thaninahamidouche/Projet-Robotique-GRP4/Lanceur VFinal.jpeg

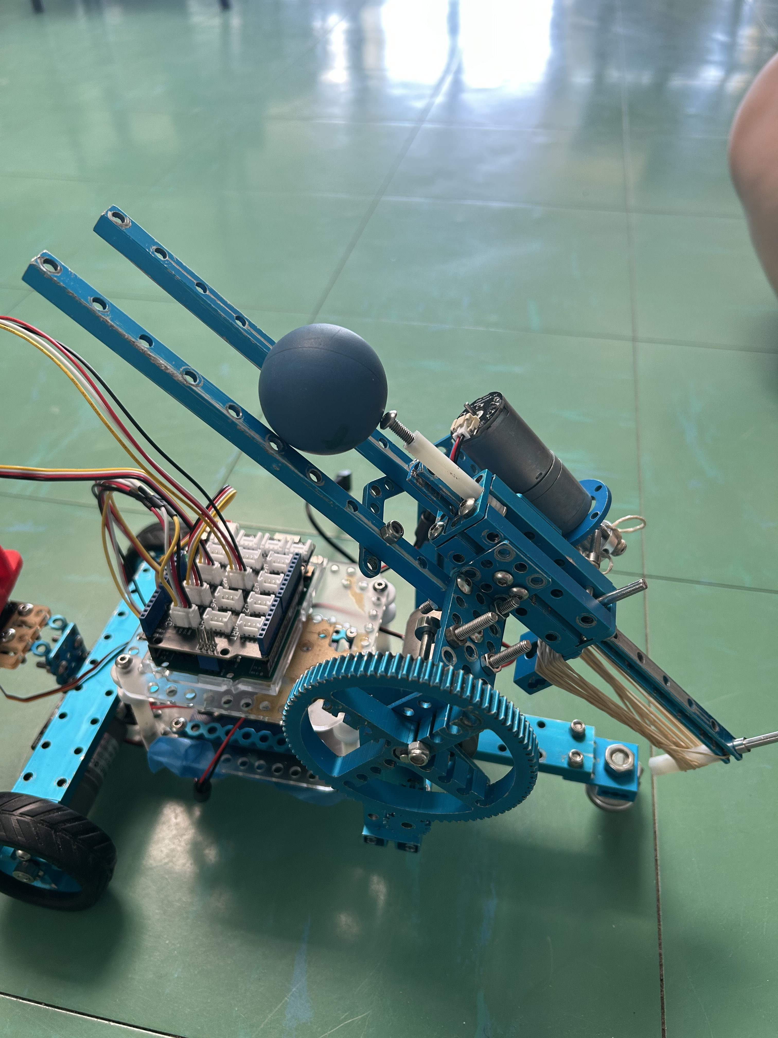
Lanceur VFinal.jpeg
