thaninahamidouche/Projet-Robotique-GRP4/Chronometrage/README.md

# Circuit de Chronométrage

## Présentation

Dans le cadre du projet robotique, j'ai conçu et réalisé un circuit de chronométrage permettant de mesurer automatiquement le temps de passage du robot entre deux barrières de détection.

Le circuit est basé sur des composants logiques et permet d'afficher le temps mesuré sur deux afficheurs 7 segments.

## Objectif

L'objectif du projet est de :

- Déclencher automatiquement le chronomètre lors du passage du robot devant la première barrière.
- Arrêter automatiquement le comptage à la seconde barrière.
- Afficher le temps mesuré sur deux afficheurs 7 segments.
- Concevoir une carte électronique fonctionnelle sous KiCad.

## Travail réalisé

J'ai réalisé l'ensemble de la partie chronométrage du projet :

- Étude du cahier des charges.
- Conception du schéma électronique.
- Choix des composants et des footprints.
- Conception et routage du PCB sous KiCad.
- Analyse et correction des erreurs du circuit.
- Préparation de la documentation technique.

## Composants utilisés

- NE555 : génération de l'horloge.
- CD4013 : gestion du démarrage et de l'arrêt du comptage.
- CD4518 : compteur BCD.
- CD4511 : décodeur pour afficheurs 7 segments.
- Afficheurs 7 segments.
- Connecteur DB25.

## Difficultés rencontrées

Le développement du circuit a nécessité plusieurs phases de correction et d'adaptation :

- Reprise du typon à plusieurs reprises.
- Correction du routage après analyse du circuit.
- Contraintes liées à la fabrication et aux tests.
- Adaptation du circuit suite aux modifications demandées durant le projet.

Malgré ces contraintes, le circuit a été entièrement analysé, corrigé et finalisé (par moi).

## Compétences développées

- Électronique numérique
- Conception de schémas électroniques
- Routage PCB sous KiCad
- Analyse et correction de circuits
- Gestion de versions avec GitHub
- Résolution de problèmes techniques
- Perçage, soudage et implantation de composants en même pas 2h.

## Auteur

Sarah Rabia

Projet Robotique – Circuit de Chronométrage

Année universitaire 2025-2026
