thaninahamidouche/Projet-Robotique-GRP4/20260519_163420.jpg

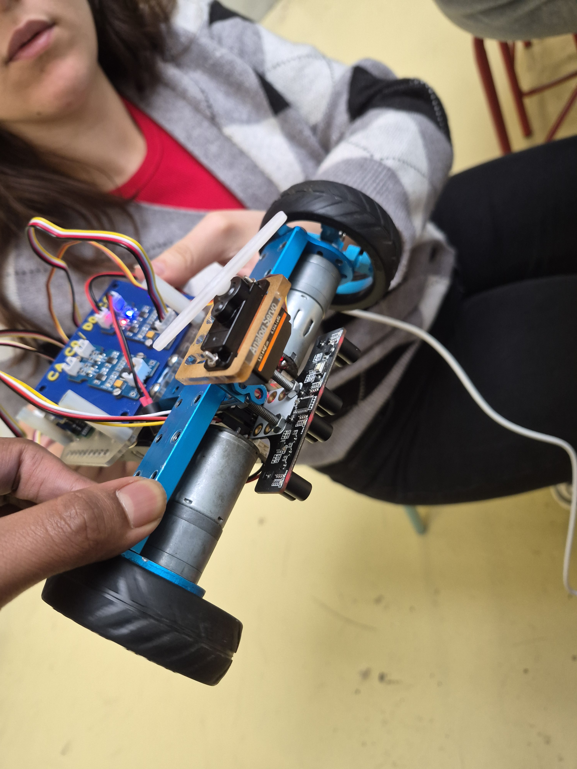
20260519_163420.jpg
