thaninahamidouche/Projet-Robotique-GRP4/20260521_100904.jpg

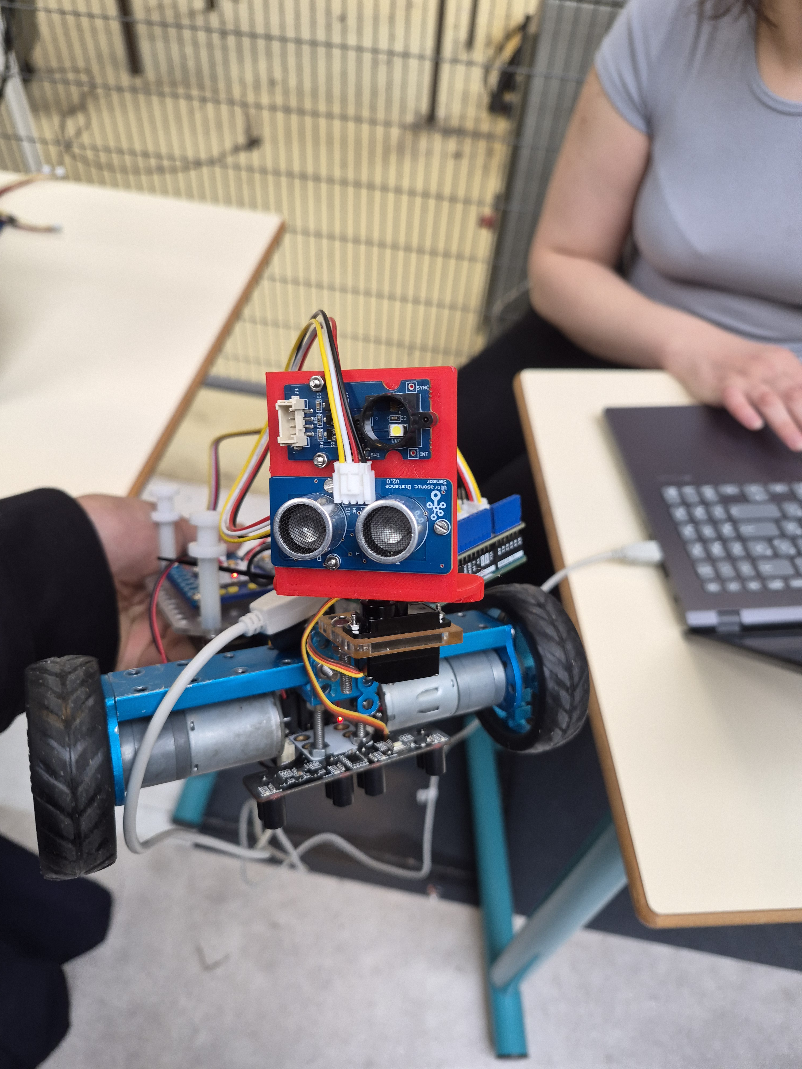
20260521_100904.jpg
