thaninahamidouche/Projet-Robotique-GRP4/20260522_160010.jpg

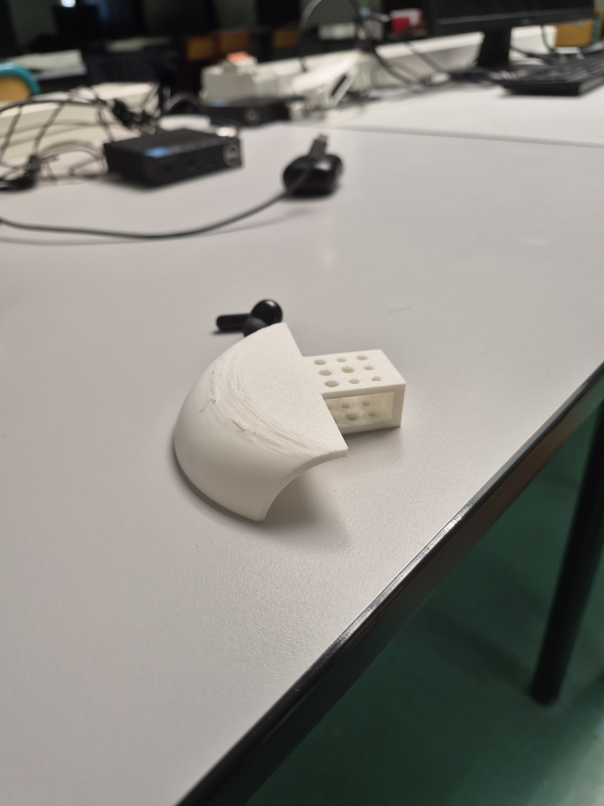
20260522_160010.jpg
