thaninahamidouche/Projet-Robotique-GRP4/Capture d’écran 2026-05-24 160932.png

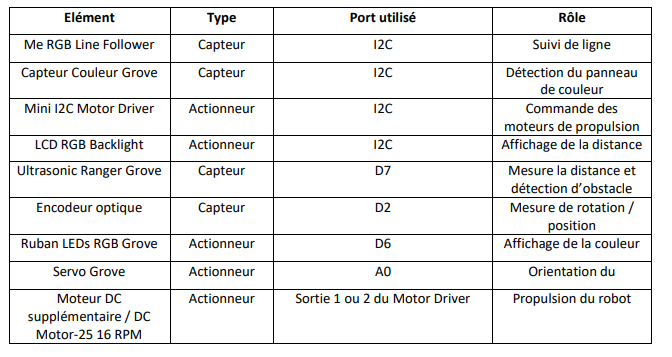
Capture d’écran 2026-05-24 160932.png
