thaninahamidouche/Projet-Robotique-GRP4/Chronometrage/Circuit_Final.jpeg

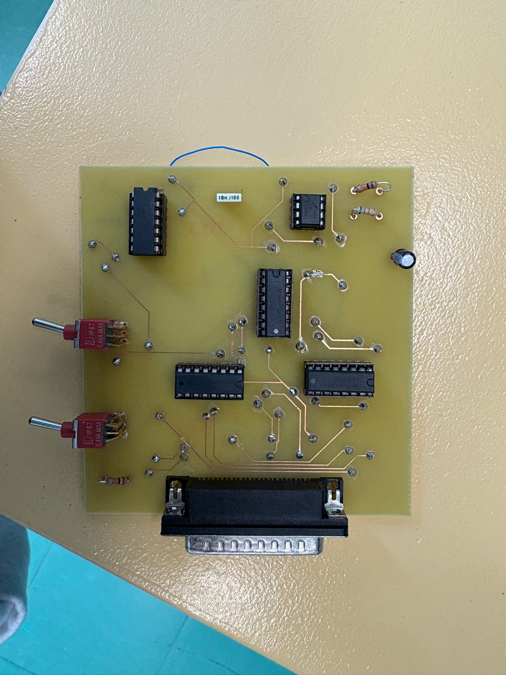
Chronometrage/Circuit_Final.jpeg
