thaninahamidouche/Projet-Robotique-GRP4/Chronometrage/Circuit_Finale_B.jpeg

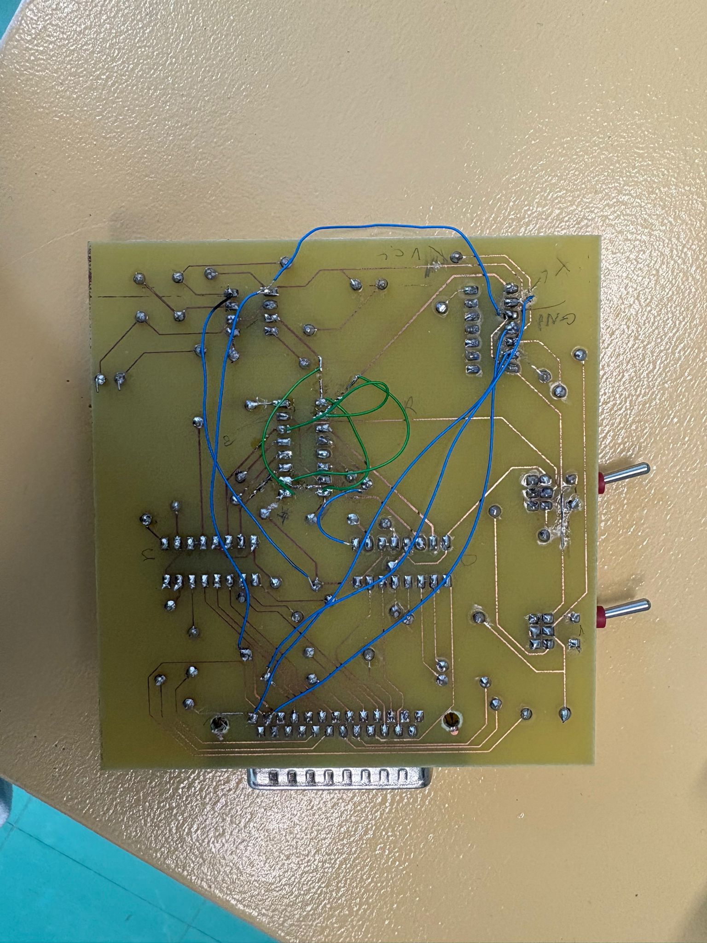
Chronometrage/Circuit_Finale_B.jpeg
