thaninahamidouche/Projet-Robotique-GRP4/Chronometrage/PCB_Chrono.png

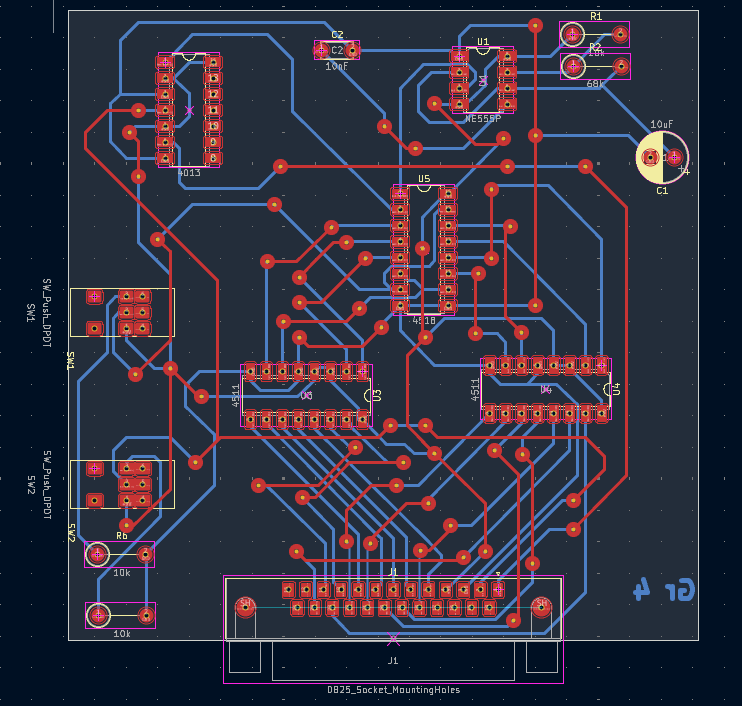
Chronometrage/PCB_Chrono.png
