thaninahamidouche/Projet-Robotique-GRP4/Chronometrage/Schematic_Chrono.png

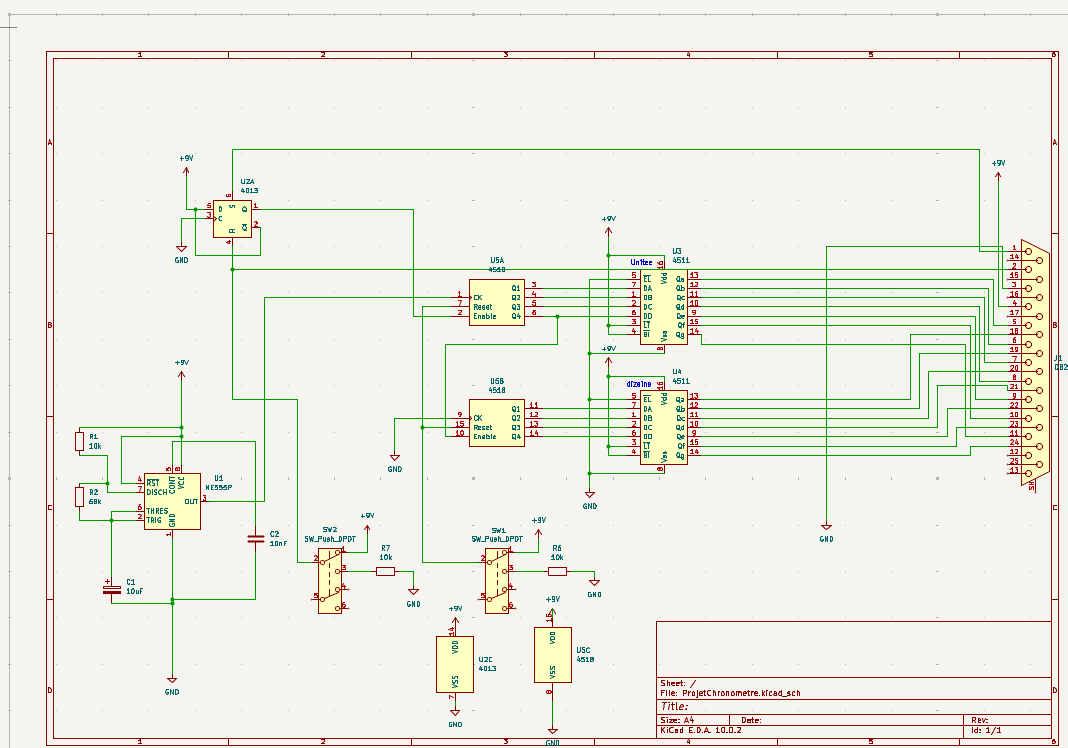
Chronometrage/Schematic_Chrono.png
