thaninahamidouche/Projet-Robotique-GRP4/Chronometrage/Shematic_Chrono_Apres_modif.png

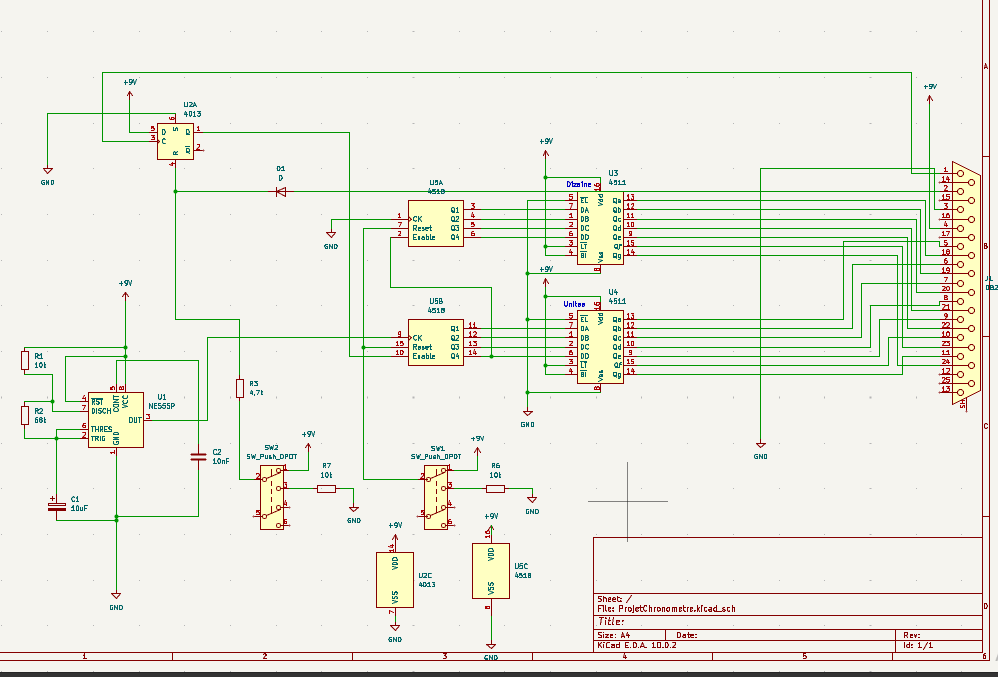
Chronometrage/Shematic_Chrono_Apres_modif.png
