thaninahamidouche/Projet-Robotique-GRP4/Chronometrage/Simulation_Chrono.png

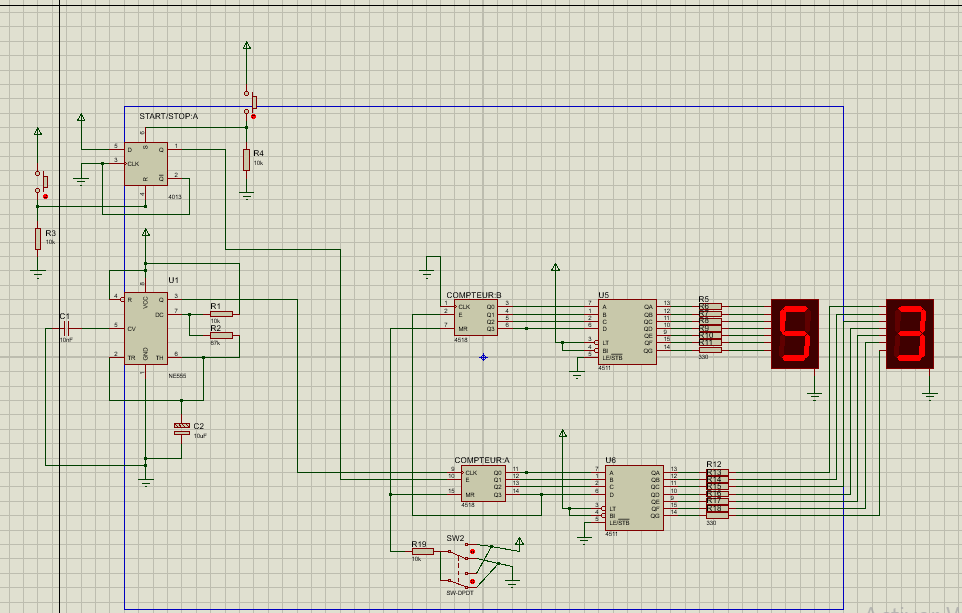
Chronometrage/Simulation_Chrono.png
