thaninahamidouche/Projet-Robotique-GRP4/Chronometrage/Simulation_reel.jpeg

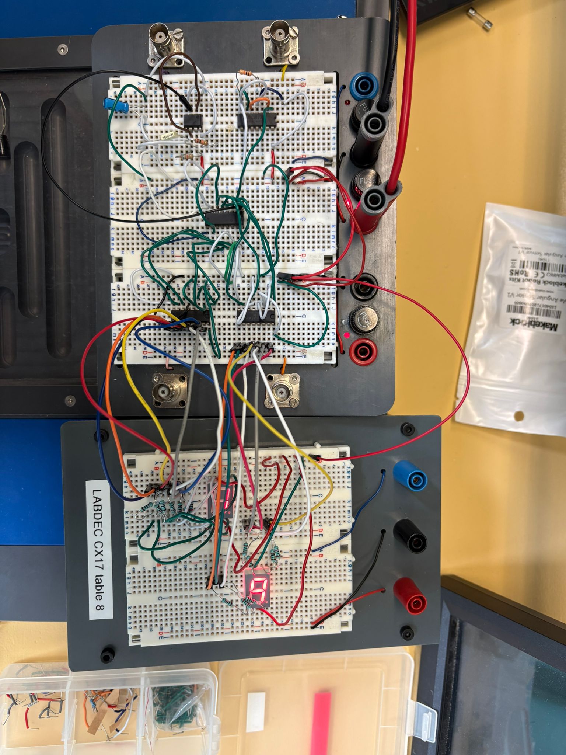
Chronometrage/Simulation_reel.jpeg
