thaninahamidouche/Projet-Robotique-GRP4/Chronometrage/Vu3D.png

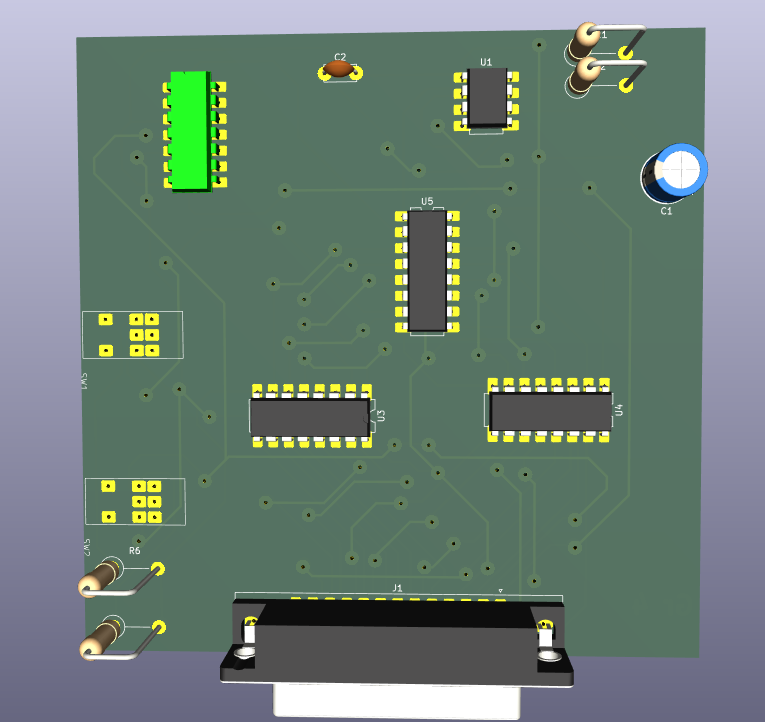
Chronometrage/Vu3D.png
