thaninahamidouche/Projet-Robotique-GRP4/Lanceur Final.jpeg

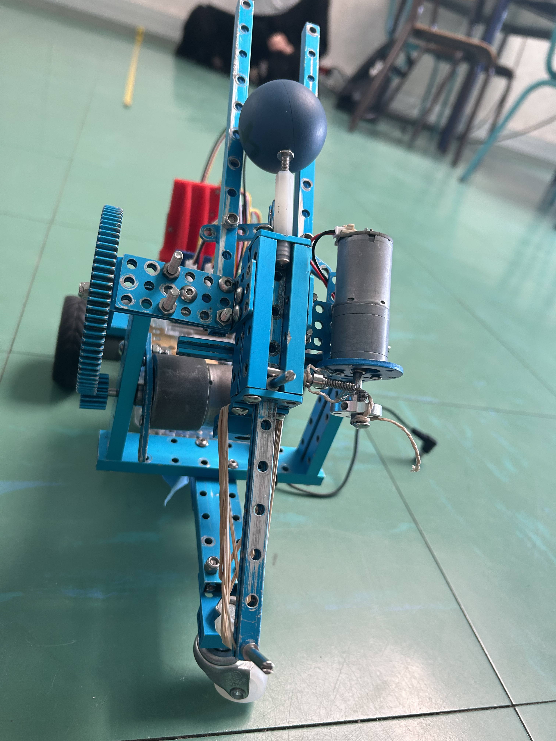
Lanceur Final.jpeg
