thaninahamidouche/Projet-Robotique-GRP4/Lanceur V1.jpeg

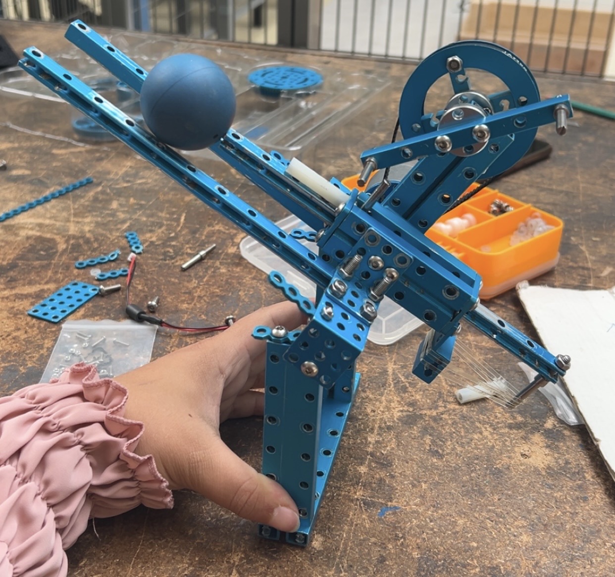
Lanceur V1.jpeg
