thaninahamidouche/Projet-Robotique-GRP4/02.Programmes Sections/afficahgerampe.V3/afficahgerampe.V3.ino

#include <Arduino.h>
#include <Wire.h>
#include <MeOrion.h>
#include <Adafruit_NeoPixel.h>

// ==================================================
// BRANCHEMENTS
// Ruban LED        -> D6
// Ultrason         -> D7
// Capteur couleur  -> I2C
// ==================================================

const int sigPin = 7;

// ==================================================
// RUBAN LED
// ==================================================

#define LED_PIN 6
#define NB_LEDS 30

Adafruit_NeoPixel strip(NB_LEDS, LED_PIN, NEO_GRB + NEO_KHZ800);

// ==================================================
// MOTEURS
// ==================================================

#define MOTEUR_A 0x66
#define MOTEUR_B 0x68

#define ARRET   0x00
#define AVANT   0x01
#define ARRIERE 0x02

const byte VITESSE = 30;

// Distance arrêt
const float DIST_STOP = 2.0;

// ==================================================
// CAPTEUR COULEUR I2C
// ==================================================

#define COLOR_ADDR 0x29

// ==================================================
// SETUP
// ==================================================

void setup() {

  Serial.begin(9600);
  Wire.begin();

  // Ruban LED
  strip.begin();
  strip.clear();
  strip.show();

  // Capteur couleur
  initColorSensor();

  arreter();

  Serial.println("Robot pret");
}

// ==================================================
// LOOP
// ==================================================

void loop() {

  float distance = mesurerDistance();

  Serial.print("Distance : ");
  Serial.print(distance);
  Serial.println(" cm");

  // STOP à 2 cm
  if(distance <= DIST_STOP && distance > 0) {

    arreter();
    delay(50);

    arreter();

    Serial.println("STOP - obstacle detecte");

    delay(500);

    afficherCouleur();

    while(true) {
      arreter();
    }
  }

  avancer();

  delay(20);
}

// ==================================================
// ULTRASON D7
// ==================================================

float mesurerDistance() {

  pinMode(sigPin, OUTPUT);

  digitalWrite(sigPin, LOW);
  delayMicroseconds(2);

  digitalWrite(sigPin, HIGH);
  delayMicroseconds(10);

  digitalWrite(sigPin, LOW);

  pinMode(sigPin, INPUT);

  long duree = pulseIn(sigPin, HIGH, 30000);

  if(duree == 0) {
    return 400;
  }

  float distance = duree * 0.034 / 2.0;

  return distance;
}

// ==================================================
// MOTEURS
// ==================================================

void piloterMoteur(byte adresse, byte direction, byte vitesse) {

  if(vitesse > 63) {
    vitesse = 63;
  }

  byte commande = (vitesse << 2) | direction;

  Wire.beginTransmission(adresse);
  Wire.write(0x00);
  Wire.write(commande);
  Wire.endTransmission();
}

void avancer() {

  piloterMoteur(MOTEUR_A, AVANT, VITESSE);
  piloterMoteur(MOTEUR_B, ARRIERE, VITESSE);
}

void arreter() {

  piloterMoteur(MOTEUR_A, ARRET, 0);
  piloterMoteur(MOTEUR_B, ARRET, 0);

  delay(20);

  // sécurité
  piloterMoteur(MOTEUR_A, ARRET, 0);
  piloterMoteur(MOTEUR_B, ARRET, 0);
}

// ==================================================
// CAPTEUR COULEUR
// ==================================================

void writeColorRegister(byte reg, byte value) {

  Wire.beginTransmission(COLOR_ADDR);
  Wire.write(0x80 | reg);
  Wire.write(value);
  Wire.endTransmission();
}

uint16_t readColorRegister16(byte reg) {

  Wire.beginTransmission(COLOR_ADDR);
  Wire.write(0x80 | reg);
  Wire.endTransmission();

  Wire.requestFrom(COLOR_ADDR, 2);

  if(Wire.available() < 2) {
    return 0;
  }

  uint16_t low = Wire.read();
  uint16_t high = Wire.read();

  return (high << 8) | low;
}

void initColorSensor() {

  writeColorRegister(0x00, 0x03);
  writeColorRegister(0x01, 0xEB);
  writeColorRegister(0x0F, 0x01);

  delay(100);
}

// ==================================================
// DETECTION COULEUR
// ==================================================

void afficherCouleur() {

  uint16_t red   = readColorRegister16(0x16);
  uint16_t green = readColorRegister16(0x18);
  uint16_t blue  = readColorRegister16(0x1A);

  Serial.println("===== COULEUR =====");

  Serial.print("R = ");
  Serial.print(red);

  Serial.print(" | G = ");
  Serial.print(green);

  Serial.print(" | B = ");
  Serial.println(blue);

  // ROUGE
  if(red > green && red > blue) {

    Serial.println("Couleur : ROUGE");

    afficherRuban(
      strip.Color(255,0,0)
    );
  }

  // VERT
  else if(green > red && green > blue) {

    Serial.println("Couleur : VERT");

    afficherRuban(
      strip.Color(0,255,0)
    );
  }

  // BLEU
  else if(blue > red && blue > green) {

    Serial.println("Couleur : BLEU");

    afficherRuban(
      strip.Color(0,0,255)
    );
  }

  // AUTRE
  else {

    Serial.println("Couleur : INCONNUE");

    afficherRuban(
      strip.Color(255,255,255)
    );
  }
}

// ==================================================
// RUBAN LED CLIGNOTANT
// 0.5 s pendant 3 s
// ==================================================

void afficherRuban(uint32_t couleur) {

  // 6 cycles = 3 secondes
  for(int cycle=0; cycle<3; cycle++) {

    // ALLUME
    for(int i=0;i<NB_LEDS;i++) {

      strip.setPixelColor(i,couleur);
    }

    strip.show();

    delay(500);

    // ETEINT
    strip.clear();
    strip.show();

    delay(500);
  }
}
