thaninahamidouche/Projet-Robotique-GRP4/(commit log)

2026-05-14 Programmes des sections
2026-05-18 Add files via upload
    On va trouver sur ce zip les fichiers de l'impression en 3D de support d'ultrason et le programme pour eviter l'obstacle
2026-05-20 Create ProgrammedePFC
    programme de projet robotique du Sarah de PFC
2026-05-22 Create chronometre
    circuit de chronométrage
2026-05-24 Image du robot
    Grace à ses image nous pouvons voir ou se trouve les different capteur et actionneur. Et le support pour l'ultrason et le detecteur de couleur
2026-05-24 Support Suivi de ligne
    Ce support sert à maintenir le Line follower et créer de l'ombre
2026-05-24 Ajout du README du circuit de chronométrage
    Ajout du README décrivant la conception et la réalisation du circuit de chronométrage.
2026-05-24 Add files via upload
    Ajout de la simulation du circuit de chronométrage que j'ai conçu et réalisé sous Proteus.
    Cette simulation a permis de vérifier le fonctionnement du système de comptage, du contrôle START/STOP et de l'affichage sur deux afficheurs 7 segments avant la réalisation du PCB sous KiCad.
2026-05-24 Ajout du schéma du circuit de chronométrage
    Ajout de la première version du schéma électronique du circuit de chronométrage réalisé sous KiCad.
    Cette version a permis de valider le principe de fonctionnement du système de comptage et d'affichage. Des modifications restent à effectuer afin d'adapter le circuit aux nouvelles contraintes liées aux afficheurs 7 segments utilisés sur les barrières du projet.
2026-05-24 Ajout de simulation réel
    Ajout des photos du montage expérimental réalisé sur plaques d'essai.
    Ces tests ont permis de valider le fonctionnement du circuit avant la réalisation de la carte PCB. Les composants principaux (NE555, CD4013, CD4518 et CD4511) ont été testés afin de vérifier le comptage et l'affichage sur les afficheurs 7 segments.
    Cette phase a également permis d'identifier et de corriger plusieurs erreurs de câblage et de conception avant la fabrication de la carte finale.
2026-05-24 Ajout du routage PCB du circuit de chronométrage
    Cette carte a été développée à partir du schéma électronique du circuit de chronométrage. Le routage a été effectué en double face afin d'optimiser l'implantation des composants et les connexions entre les différents circuits intégrés.
    Le PCB intègre notamment le NE555, le CD4013, les compteurs CD4518, les décodeurs CD4511 ainsi que le connecteur DB25 utilisé pour l'interface avec les afficheurs et les barrières de chronométrage.
2026-05-24 Ajout de la vue 3D du PCB
    Cette vue permet de visualiser l'implantation des composants sur le PCB avant fabrication. Elle facilite la vérification du placement des circuits intégrés, des connecteurs, des résistances et des condensateurs afin de détecter d'éventuels problèmes mécaniques ou d'encombrement.
2026-05-24 Ajout des photos de la carte électronique réalisée
    Ajout des photographies de la carte électronique du circuit de chronométrage après fabrication et assemblage des composants.
    Ces images présentent la version physique de la carte conçue sous KiCad, incluant le PCB gravé, le soudage des composants et les différentes modifications effectuées lors des phases de test et de validation.
    La carte a été réalisée à partir du routage conçu sous KiCad puis testée expérimentalement afin de vérifier son fonctionnement.
2026-05-24 Mise à jour du schéma du circuit de chronométrage
    Modification du schéma électronique afin d'améliorer la gestion du chronométrage entre les deux barrières.
    Ajout d'une diode de protection et d'une résistance de 4,7 kΩ pour stabiliser les signaux de commande. Le câblage du système de comptage a également été adapté afin d'assurer la compatibilité avec les nouvelles contraintes du projet et les afficheurs utilisés sur les barrières de chronométrage.
2026-05-28 Support de l'afficheur
    On a créé un support pour l'afficheur qui ne gêne pas la coque mais aussi qui reste dans la largeur du robot (Il ne dépasse pas la roue ) parce que sinon lors du passage dans le tunnel, il va gêner.
