thaninahamidouche/Projet-Robotique-GRP4/20260521_100859.jpg

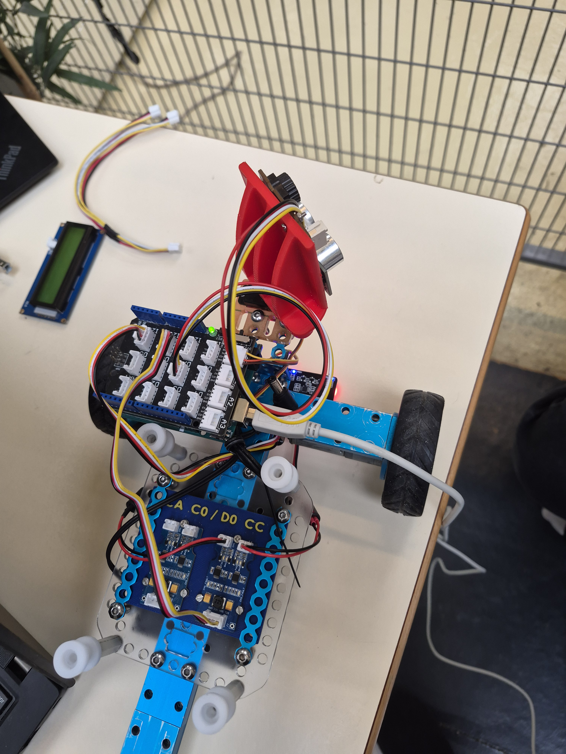
20260521_100859.jpg
