thaninahamidouche/Projet-Robotique-GRP4/20260527_155001.jpg

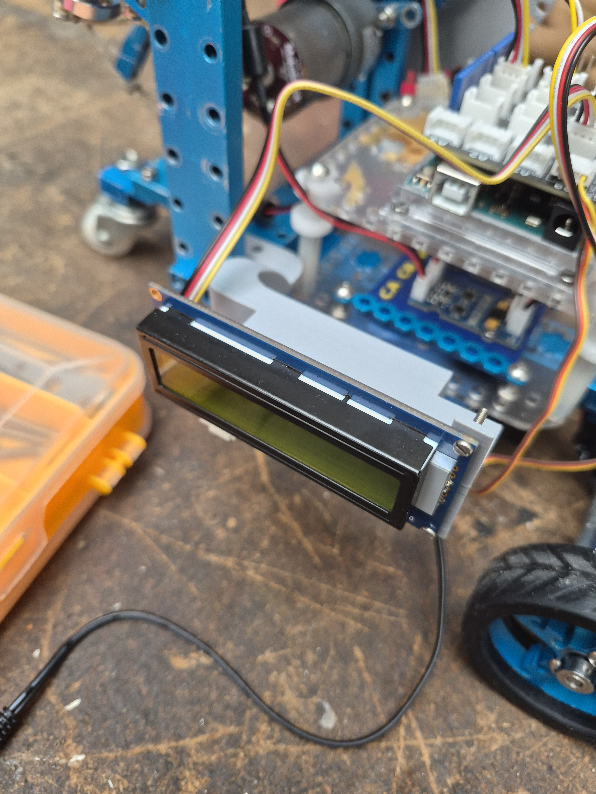
20260527_155001.jpg
