thaninahamidouche/Projet-Robotique-GRP4/20260527_155008.jpg

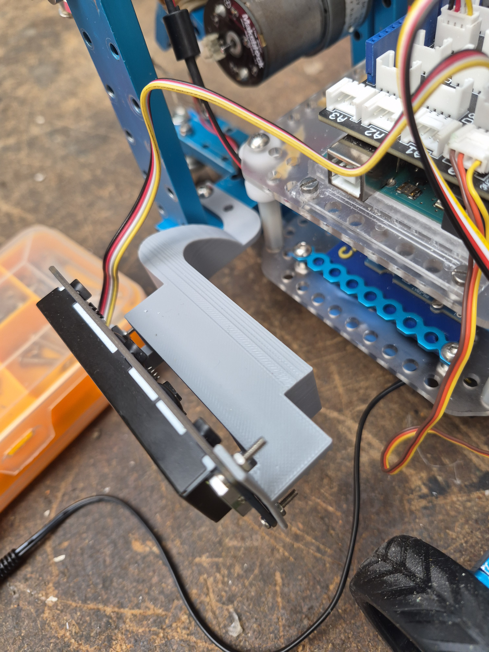
20260527_155008.jpg
