thaninahamidouche/Projet-Robotique-GRP4/20260527_155003.jpg

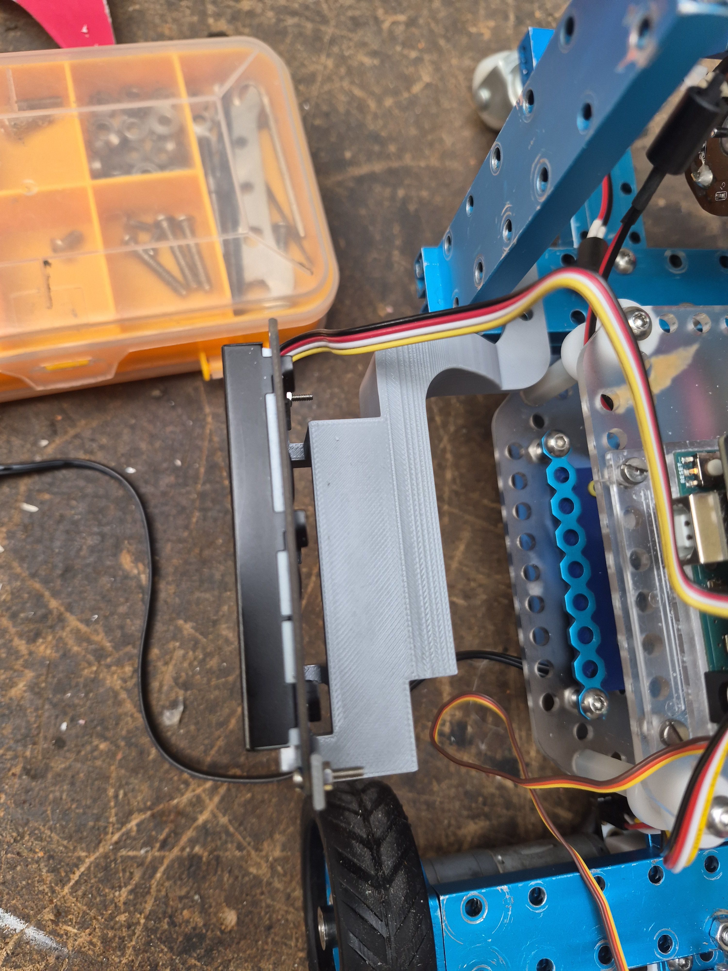
20260527_155003.jpg
